parkrrr/weather-station/img/1322361176810.jpg

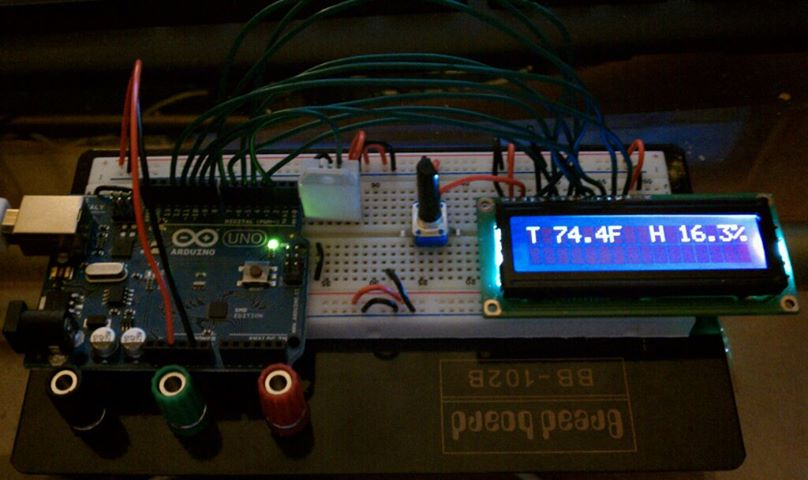
img/1322361176810.jpg
