parkrrr/weather-station/img/1325032283586.jpg

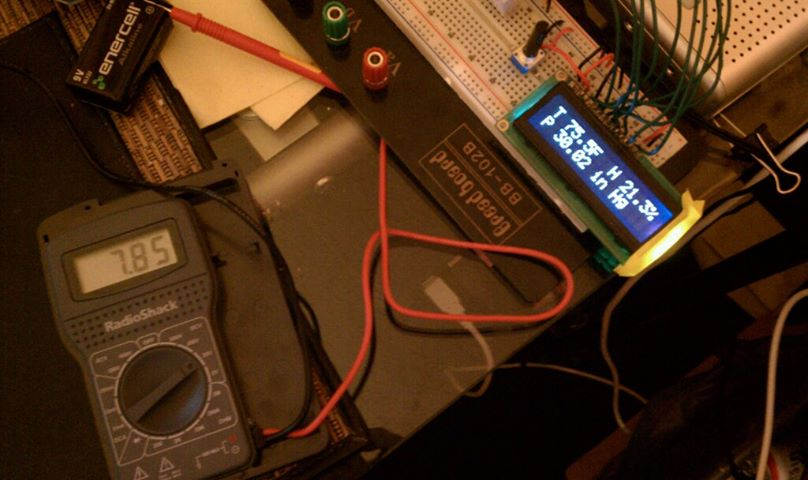
img/1325032283586.jpg
